andresc44/solidworks-cnc-mill-assembly/Solidworks/Needle-Roller_Bearing_assembly.SLDASM

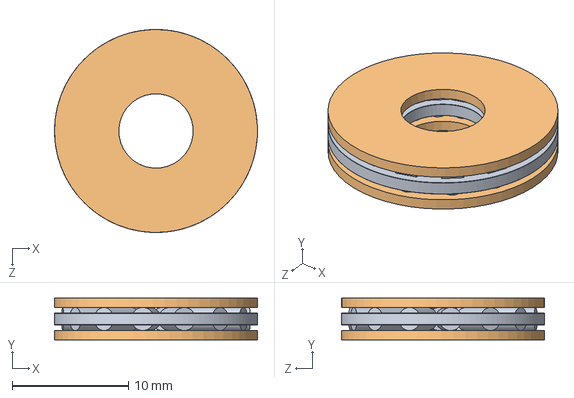
[picture p32: CAD file, 2025-07-18]
Solidworks/Needle-Roller_Bearing_assembly.SLDASM
17.5 x 3.61 x 17.5 mm
5909K230_THRUST NEEDLE-ROLLER BEARING
5909K231_THRUST NEEDLE-ROLLER BEARING x 2
