andresc44/solidworks-cnc-mill-assembly/Solidworks/C Plate assembly.SLDASM

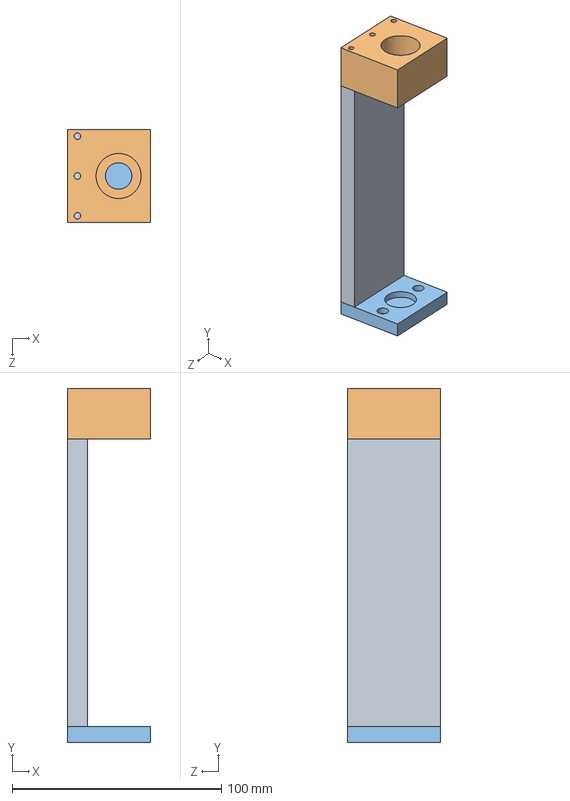
[picture p33: CAD file, 2025-07-18]
Solidworks/C Plate assembly.SLDASM
39.7 x 169.2 x 44.5 mm
Side of C plate
Top bar of C plate
bottom bar of C plate
