andresc44/solidworks-cnc-mill-assembly/Solidworks/CNC Assembly FINAL.SLDASM

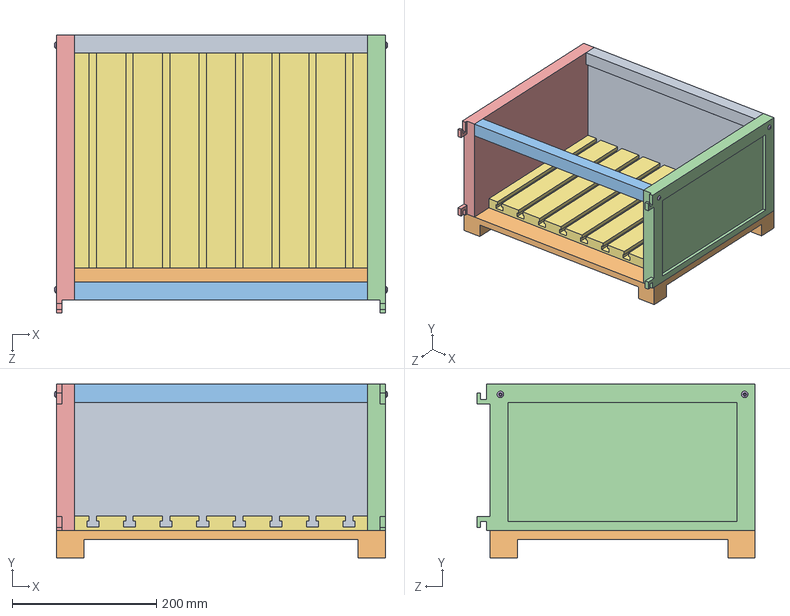
[picture p34: CAD file, 2025-07-18]
Solidworks/CNC Assembly FINAL.SLDASM
462.3 x 241.3 x 386.5 mm
frame backing
Frame bottom
frame front rod
frame sides
frame sides new
socket button head cap screw_ai x 8
12x12 t slot table
