andresc44/solidworks-cnc-mill-assembly/Solidworks/Clamp Assembly.SLDASM

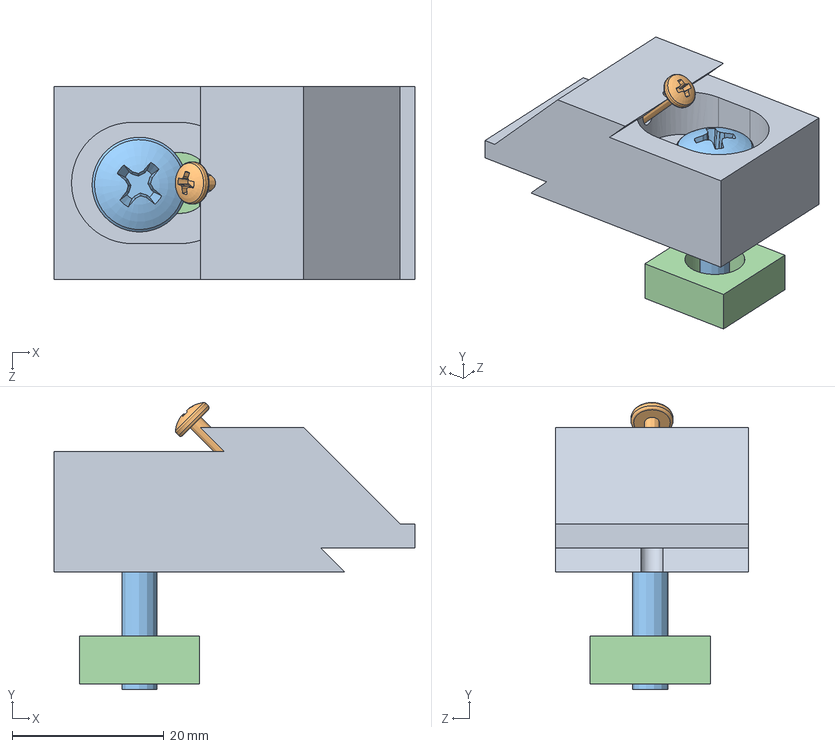
[picture p35: CAD file, 2025-07-18]
Solidworks/Clamp Assembly.SLDASM
47.6 x 37.9 x 25.4 mm
Toe clamp
91772A113_18-8 SS PAN HEAD PHILLIPS MACHINE SCREW
91735A542_TYPE 316 SS PAN HEAD PHILLIPS MACHINE SCREW
94855A278_LOW-STRENGTH STEEL SQUARE NUT
