andresc44/solidworks-cnc-mill-assembly/Solidworks/Top bar of C plate.SLDPRT

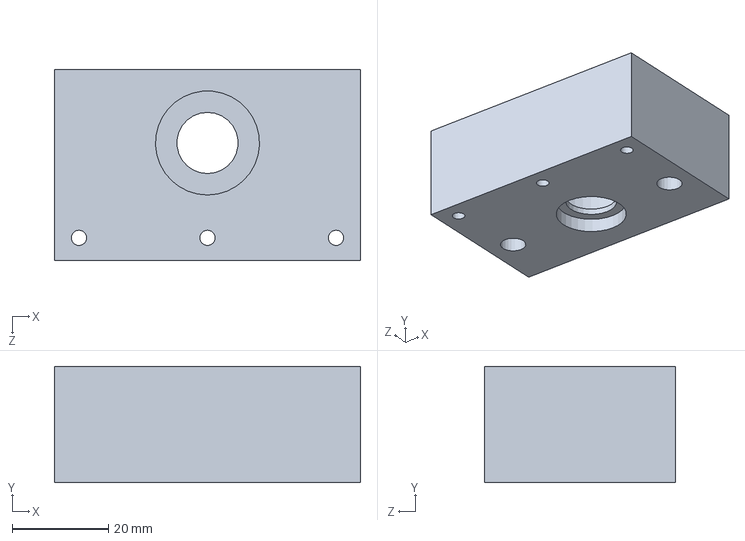
[picture p36: CAD file, 2025-07-18]
Solidworks/Top bar of C plate.SLDPRT
63.5 x 24.1 x 39.6 mm
