andresc44/solidworks-cnc-mill-assembly/Solidworks/Toe clamp.SLDPRT

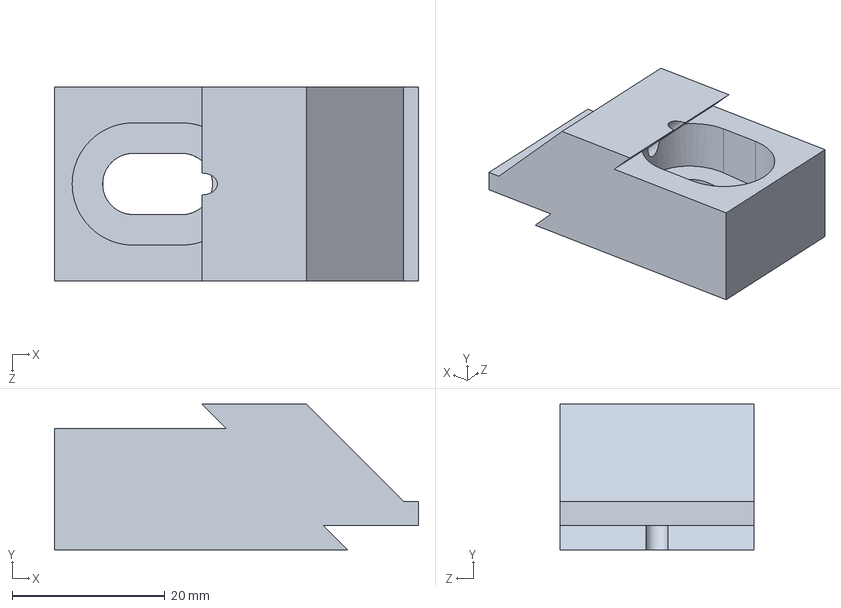
[picture p38: CAD file, 2025-07-18]
Solidworks/Toe clamp.SLDPRT
47.6 x 19.1 x 25.4 mm
