andresc44/solidworks-cnc-mill-assembly/Solidworks/Frame bottom.SLDPRT

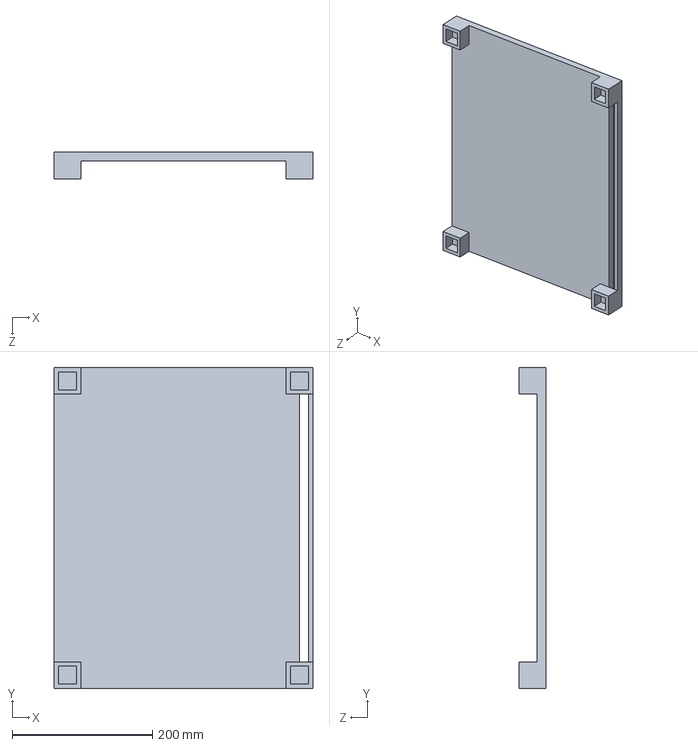
[picture p39: CAD file, 2025-07-18]
Solidworks/Frame bottom.SLDPRT
368.3 x 457.2 x 38.1 mm
