andresc44/solidworks-cnc-mill-assembly/Solidworks/motor_holder.SLDPRT

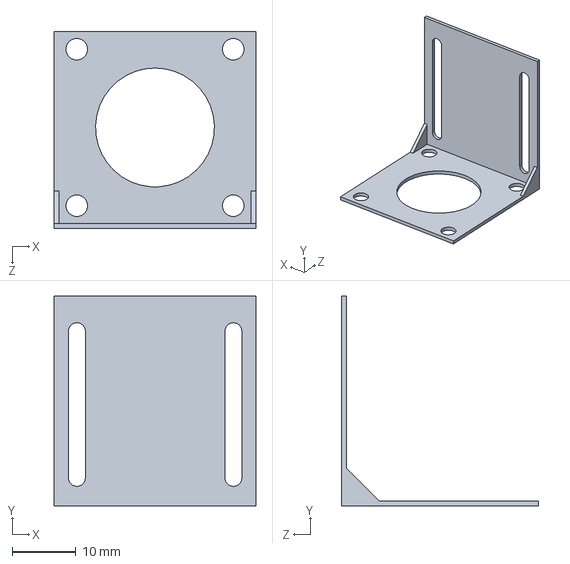
[picture p40: CAD file, 2025-07-18]
Solidworks/motor_holder.SLDPRT
31.8 x 33.0 x 31.0 mm
