andresc44/solidworks-cnc-mill-assembly/Solidworks/frame sides.SLDPRT

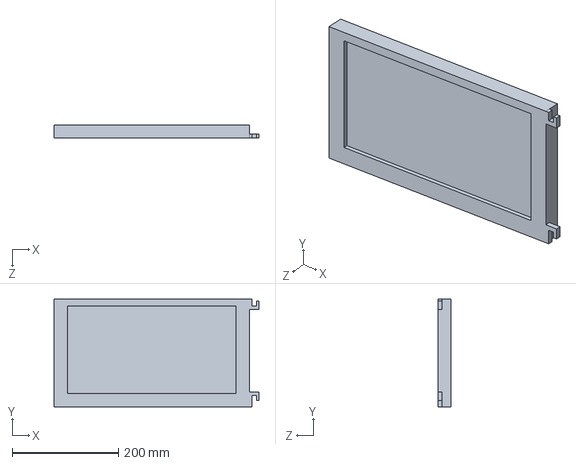
[picture p41: CAD file, 2025-07-18]
Solidworks/frame sides.SLDPRT
386.5 x 203.2 x 25.4 mm
