andresc44/solidworks-cnc-mill-assembly/Solidworks/frame front rod.SLDPRT

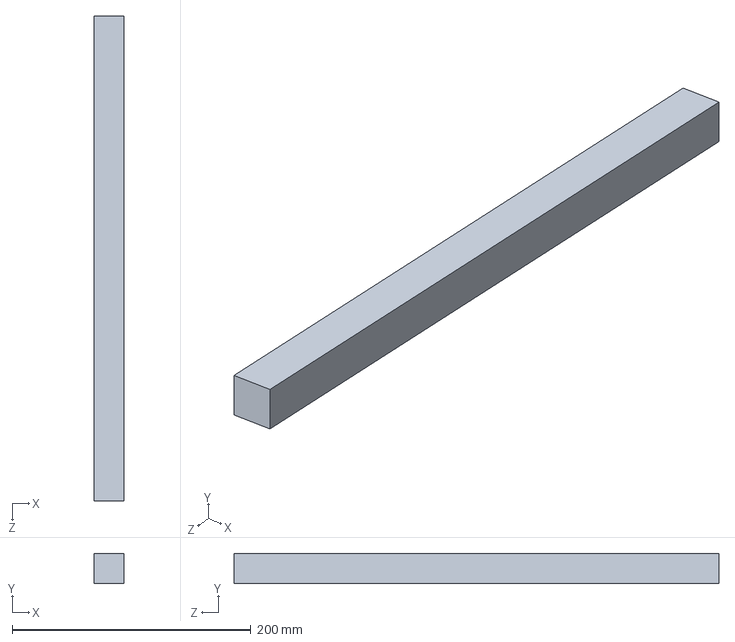
[picture p42: CAD file, 2025-07-18]
Solidworks/frame front rod.SLDPRT
25.4 x 25.4 x 406.4 mm
