andresc44/solidworks-cnc-mill-assembly/Solidworks/Side of C plate.SLDPRT

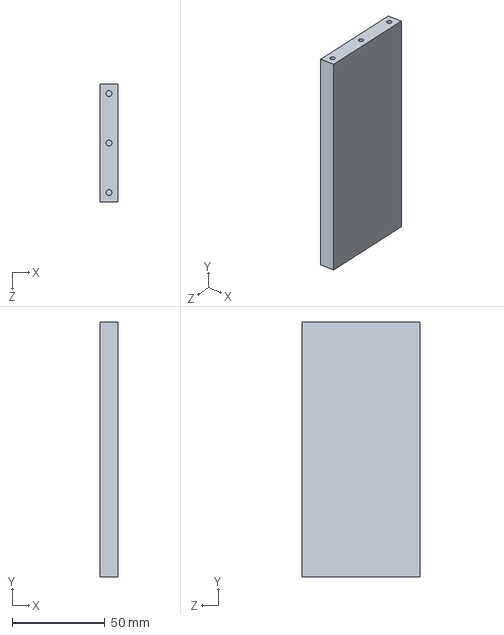
[picture p43: CAD file, 2025-07-18]
Solidworks/Side of C plate.SLDPRT
9.53 x 137.4 x 63.5 mm
