andresc44/solidworks-cnc-mill-assembly/Solidworks/traywey (1).SLDPRT

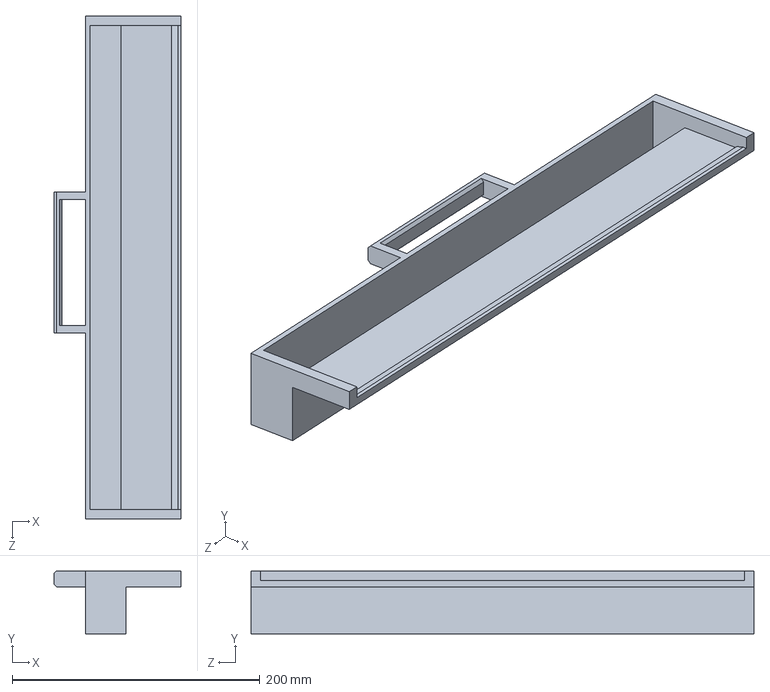
[picture p44: CAD file, 2025-07-18]
Solidworks/traywey (1).SLDPRT
102.5 x 50.8 x 406.4 mm
