andresc44/solidworks-cnc-mill-assembly/Solidworks/spindle plate vertical.SLDPRT

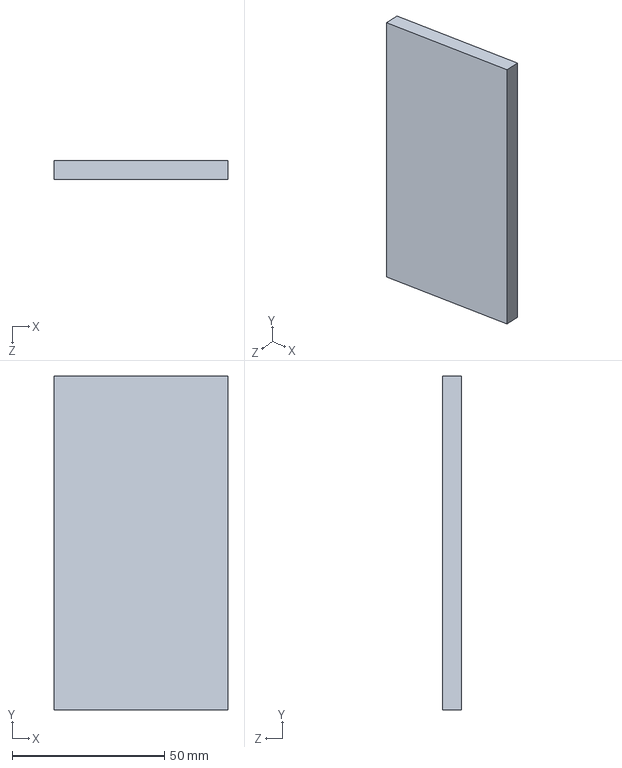
[picture p45: CAD file, 2025-07-18]
Solidworks/spindle plate vertical.SLDPRT
57.2 x 109.7 x 6.35 mm
