andresc44/solidworks-cnc-mill-assembly/Solidworks/Spindle holder top.SLDPRT

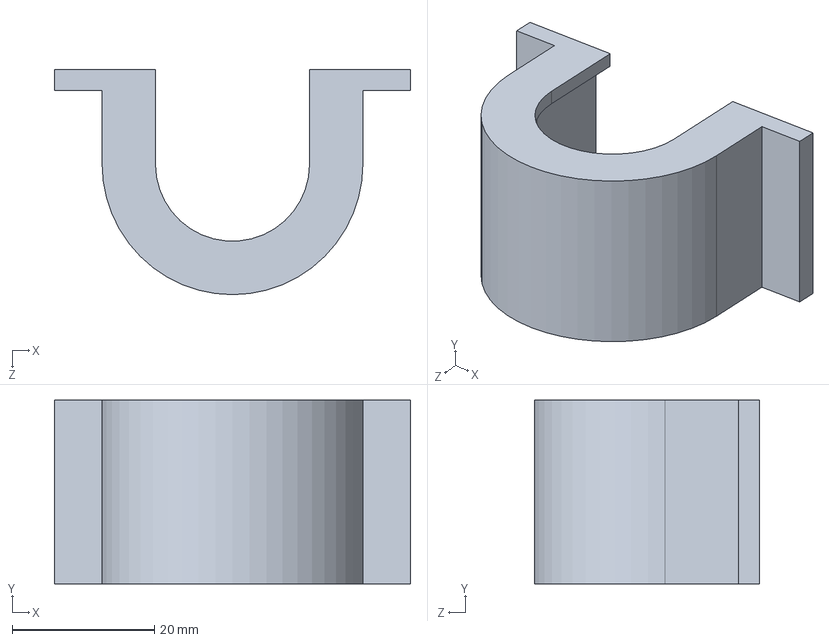
[picture p46: CAD file, 2025-07-18]
Solidworks/Spindle holder top.SLDPRT
50.0 x 25.8 x 31.6 mm
