andresc44/solidworks-cnc-mill-assembly/Solidworks/Housing for X motion Parts_NO_COUPLING.SLDPRT

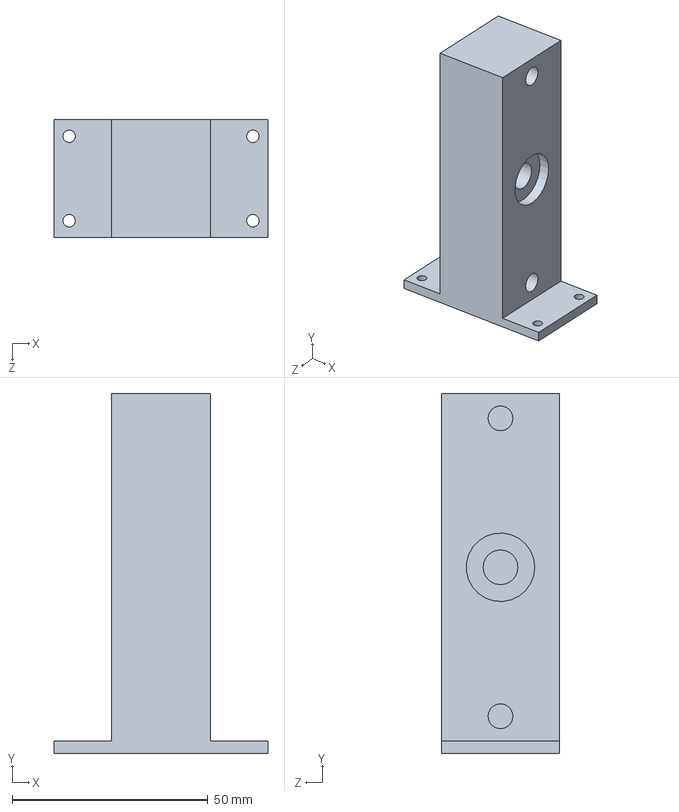
[picture p47: CAD file, 2025-07-18]
Solidworks/Housing for X motion Parts_NO_COUPLING.SLDPRT
54.6 x 92.1 x 30.2 mm
