andresc44/solidworks-cnc-mill-assembly/Solidworks/hose connector.SLDPRT

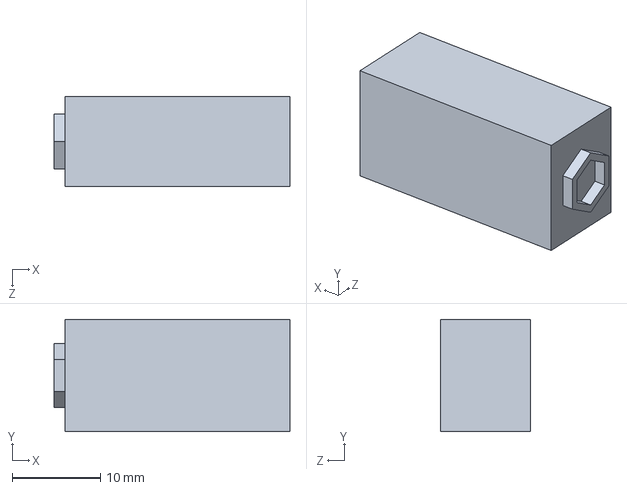
[picture p48: CAD file, 2025-07-18]
Solidworks/hose connector.SLDPRT
26.7 x 12.7 x 10.2 mm
