andresc44/solidworks-cnc-mill-assembly/Solidworks/frame backing.SLDPRT

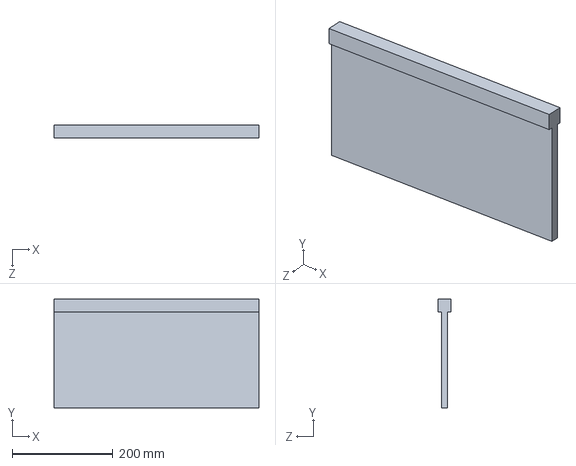
[picture p49: CAD file, 2025-07-18]
Solidworks/frame backing.SLDPRT
406.4 x 215.9 x 25.4 mm
