andresc44/solidworks-cnc-mill-assembly/Solidworks/hose.SLDPRT

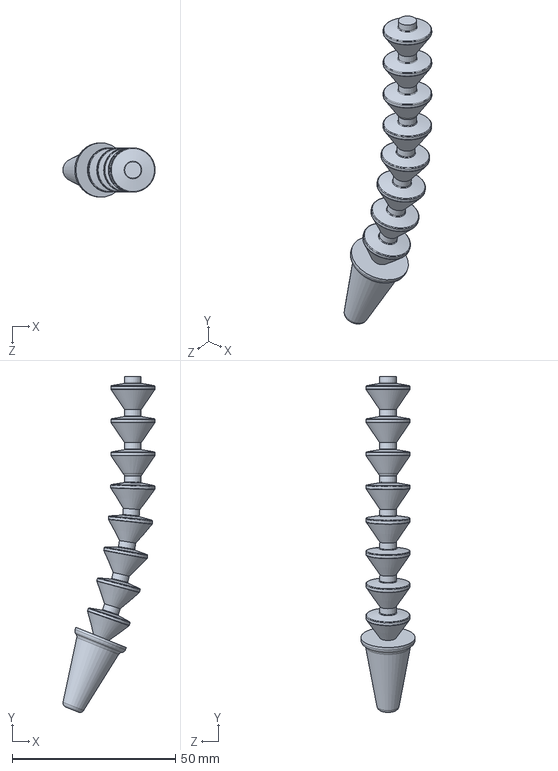
[picture p50: CAD file, 2025-07-18]
Solidworks/hose.SLDPRT
28.3 x 103.1 x 16.7 mm
