andresc44/solidworks-cnc-mill-assembly/Solidworks/Spindle holder.SLDPRT

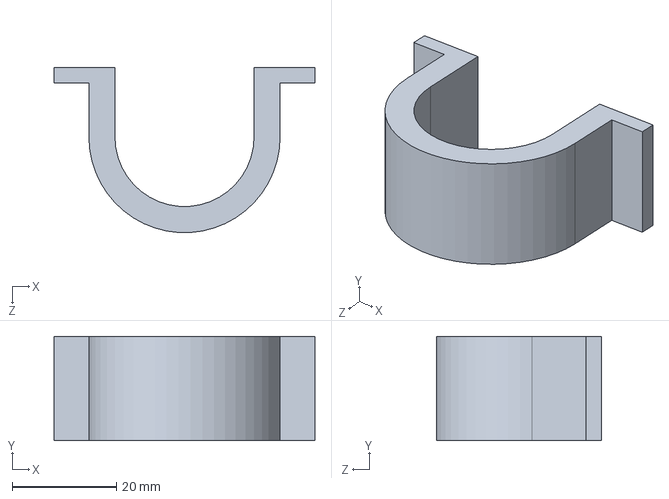
[picture p51: CAD file, 2025-07-18]
Solidworks/Spindle holder.SLDPRT
50.0 x 20.0 x 31.6 mm
