andresc44/solidworks-cnc-mill-assembly/Solidworks/motor clamp.SLDPRT

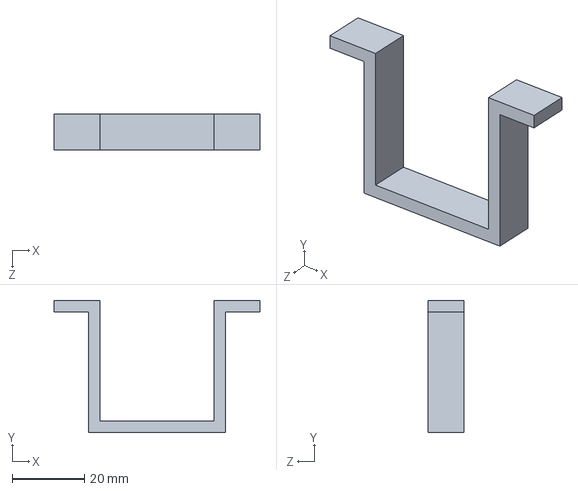
[picture p52: CAD file, 2025-07-18]
Solidworks/motor clamp.SLDPRT
57.0 x 36.6 x 10.0 mm
