andresc44/solidworks-cnc-mill-assembly/Solidworks/hose connector holder.SLDPRT

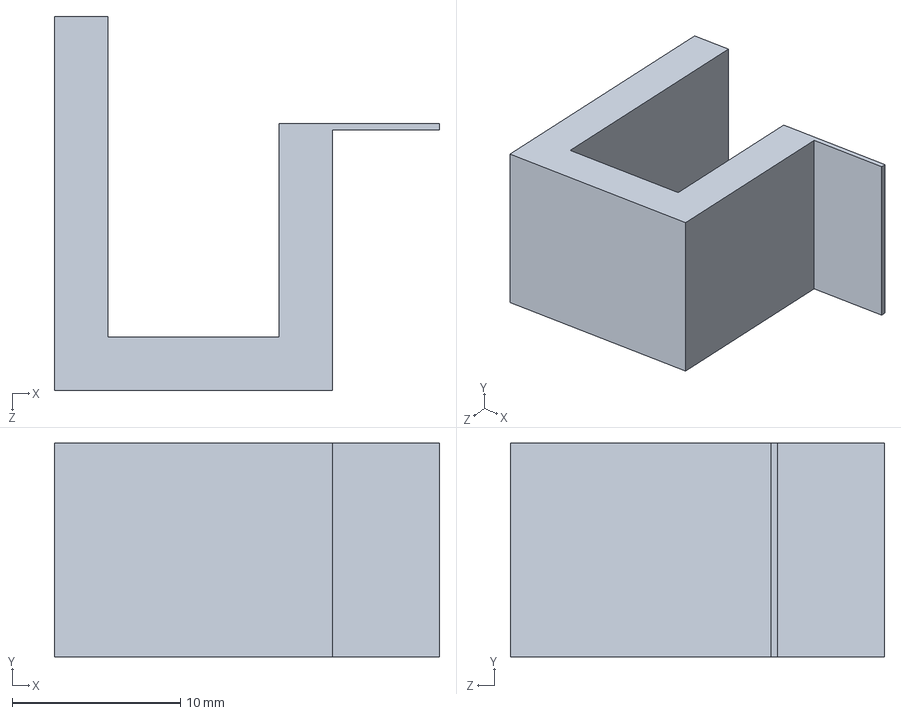
[picture p53: CAD file, 2025-07-18]
Solidworks/hose connector holder.SLDPRT
22.9 x 12.7 x 22.2 mm
