andresc44/solidworks-cnc-mill-assembly/Solidworks/Spindle.SLDPRT

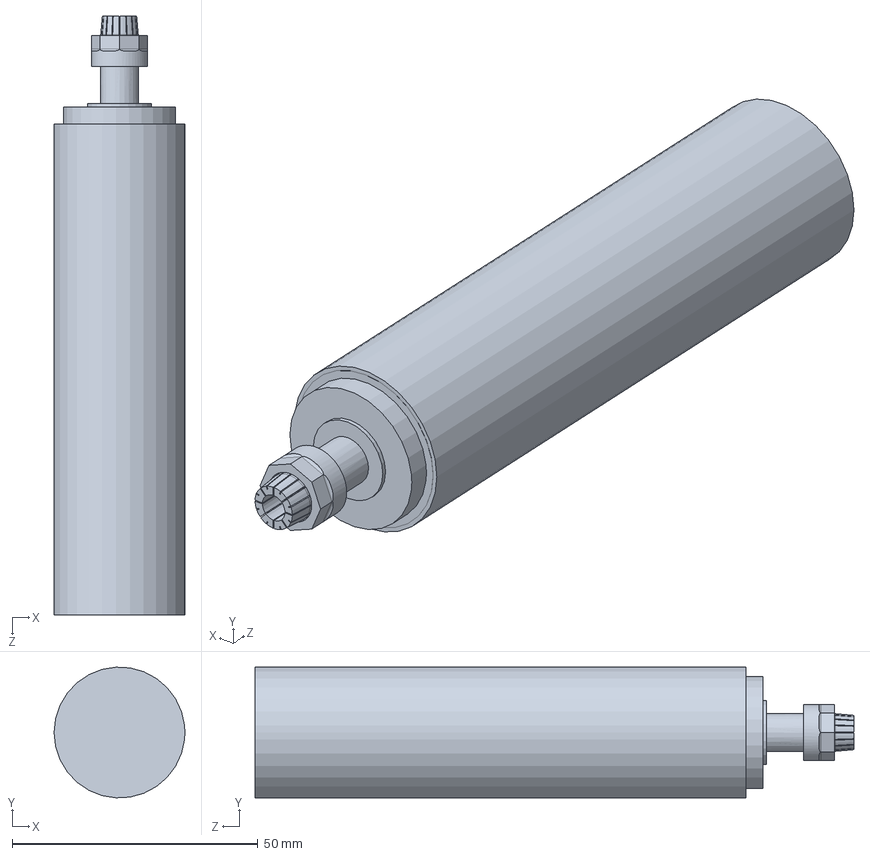
[picture p54: CAD file, 2025-07-18]
Solidworks/Spindle.SLDPRT
26.6 x 26.6 x 121.9 mm
