andresc44/solidworks-cnc-mill-assembly/Solidworks/new_new_bearing holder.SLDPRT

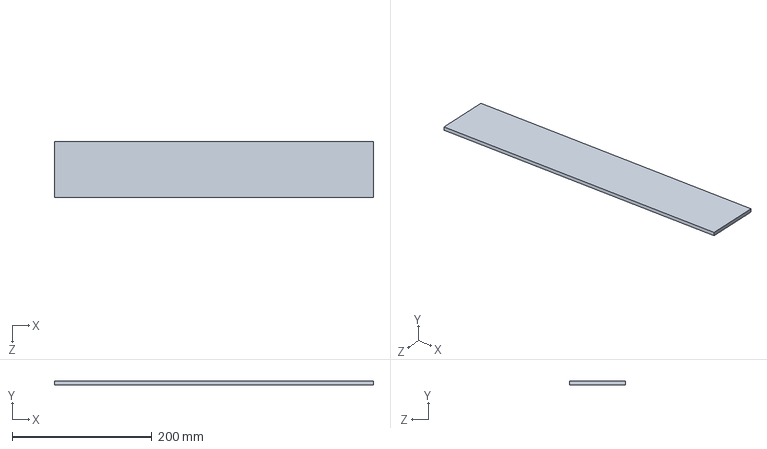
[picture p55: CAD file, 2025-07-18]
Solidworks/new_new_bearing holder.SLDPRT
457.2 x 5.08 x 80.0 mm
