andresc44/solidworks-cnc-mill-assembly/Solidworks/motor body.SLDPRT

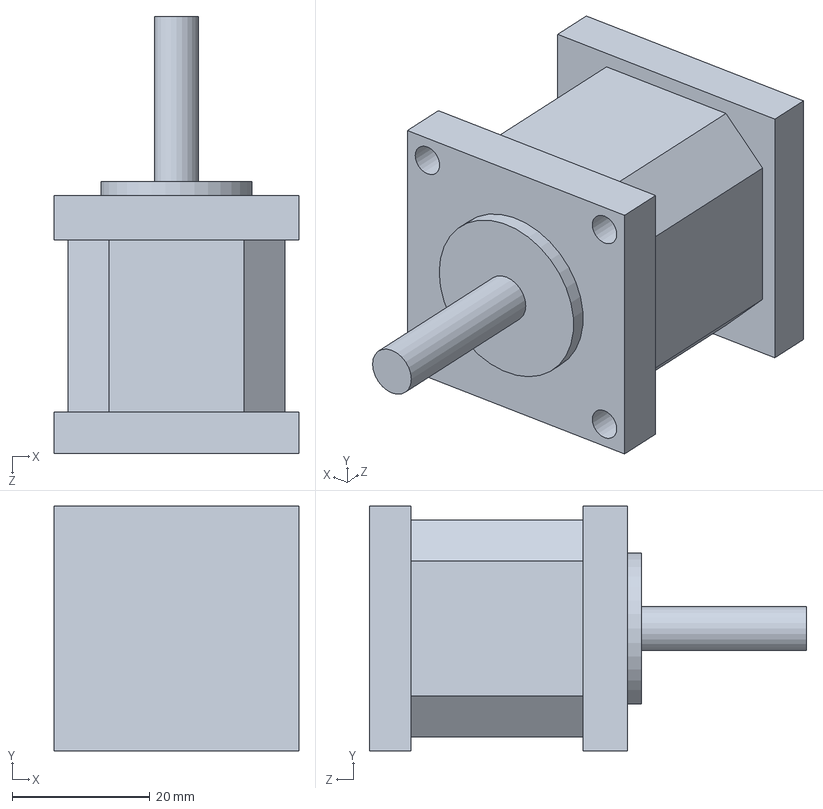
[picture p56: CAD file, 2025-07-18]
Solidworks/motor body.SLDPRT
35.6 x 35.6 x 63.5 mm
