andresc44/solidworks-cnc-mill-assembly/Solidworks/new_bearing holder.SLDPRT

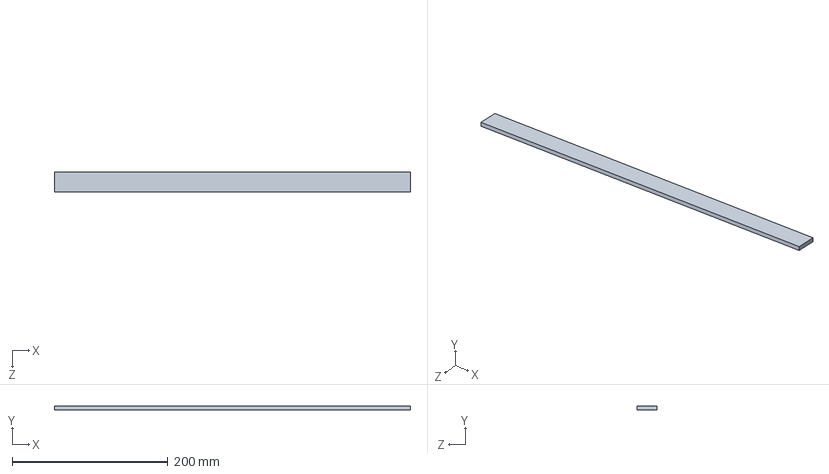
[picture p57: CAD file, 2025-07-18]
Solidworks/new_bearing holder.SLDPRT
457.2 x 5.08 x 25.4 mm
