andresc44/solidworks-cnc-mill-assembly/Solidworks/Connector plate.SLDPRT

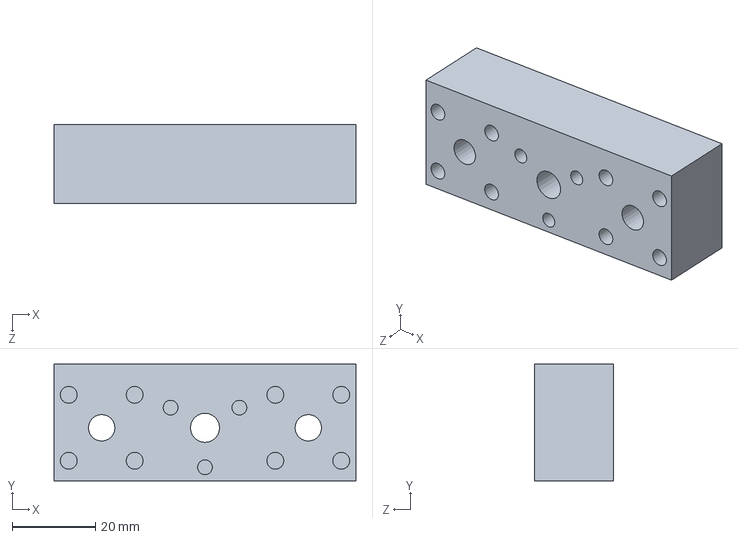
[picture p58: CAD file, 2025-07-18]
Solidworks/Connector plate.SLDPRT
72.4 x 27.9 x 19.0 mm
