andresc44/solidworks-cnc-mill-assembly/Solidworks/Bearing housing with coupling better.SLDPRT

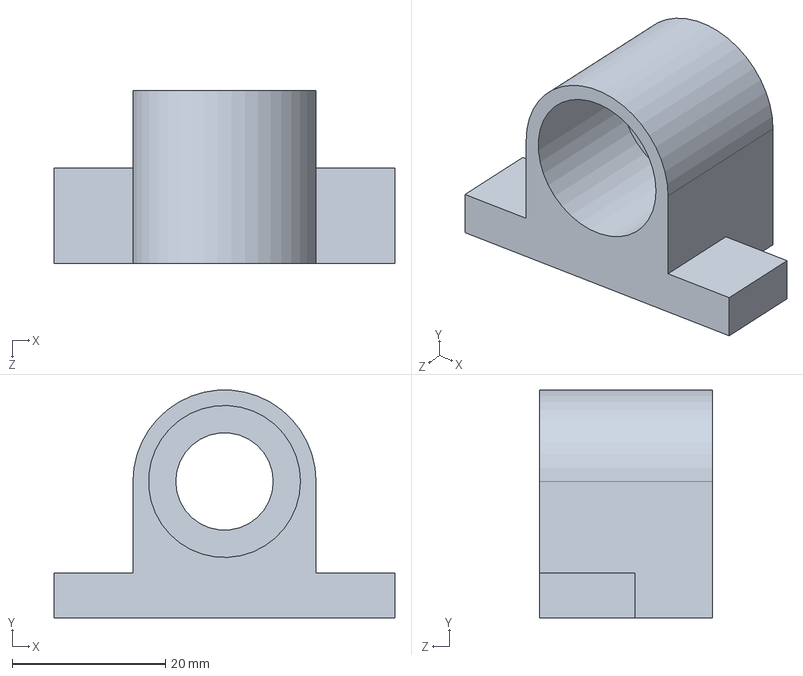
[picture p59: CAD file, 2025-07-18]
Solidworks/Bearing housing with coupling better.SLDPRT
44.5 x 29.7 x 22.6 mm
