andresc44/solidworks-cnc-mill-assembly/Solidworks/bottom bar of C plate.SLDPRT

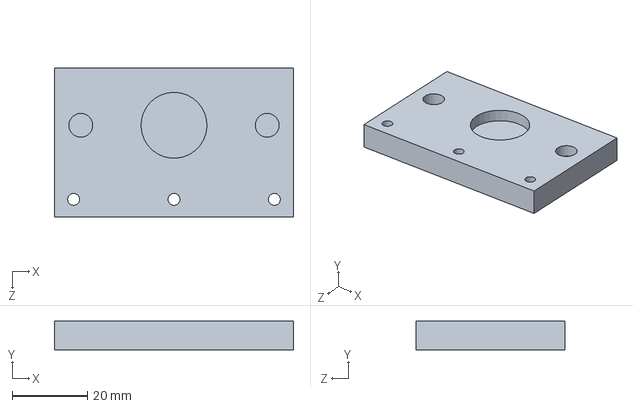
[picture p60: CAD file, 2025-07-18]
Solidworks/bottom bar of C plate.SLDPRT
63.5 x 7.62 x 39.6 mm
