andresc44/solidworks-cnc-mill-assembly/Solidworks/cnc pump.SLDPRT

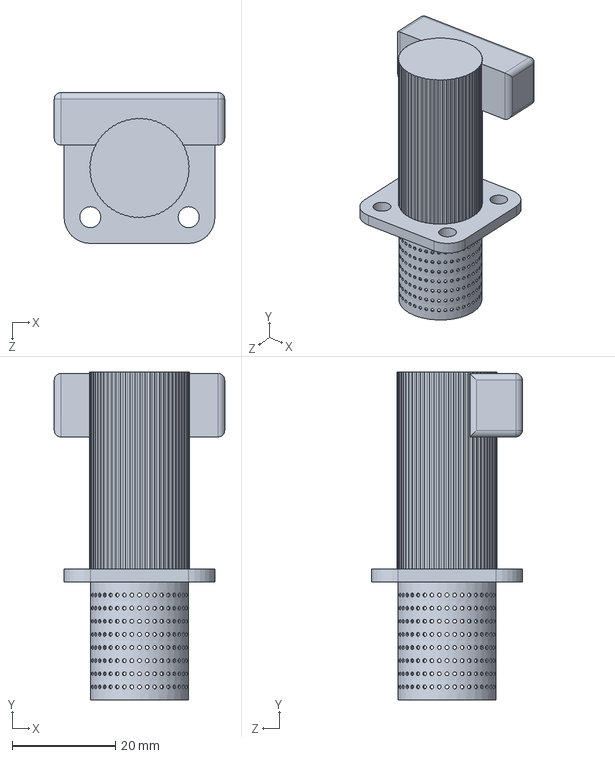
[picture p62: CAD file, 2025-07-18]
Solidworks/cnc pump.SLDPRT
33.0 x 63.5 x 29.2 mm
