andresc44/solidworks-cnc-mill-assembly/Solidworks/12 inch shaft.SLDPRT

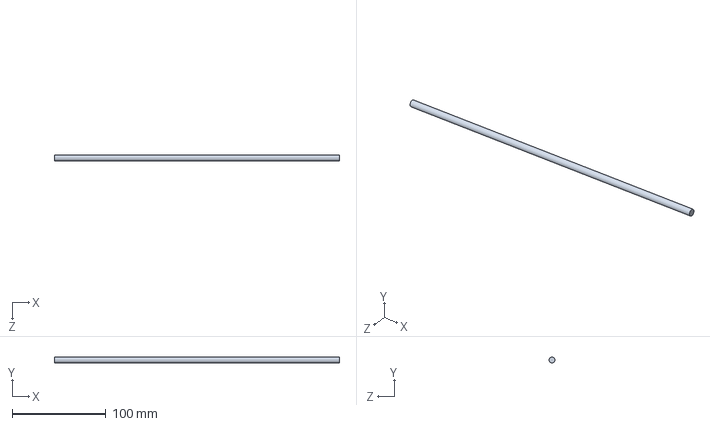
[picture p63: CAD file, 2025-07-18]
Solidworks/12 inch shaft.SLDPRT
304.8 x 6.35 x 6.35 mm
