andresc44/solidworks-cnc-mill-assembly/Solidworks/12x12 t slot table.SLDPRT

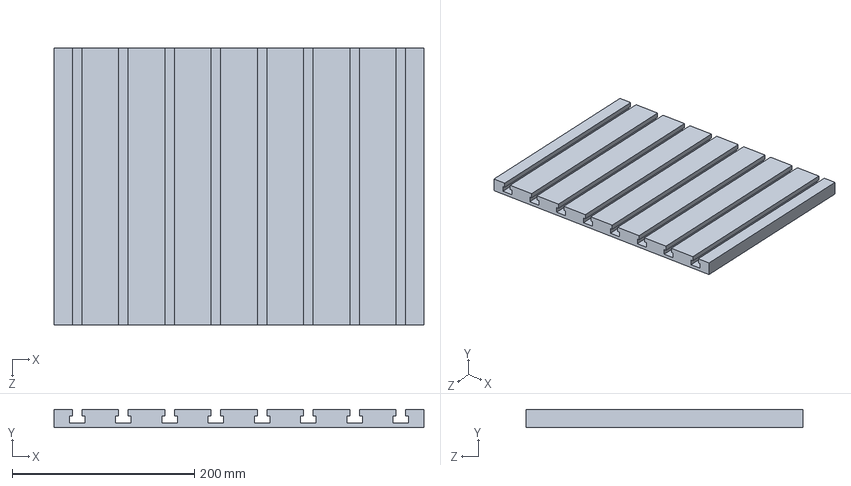
[picture p64: CAD file, 2025-07-18]
Solidworks/12x12 t slot table.SLDPRT
406.4 x 20.0 x 304.8 mm
