andresc44/solidworks-cnc-mill-assembly/Solidworks/6 inch shaft.SLDPRT

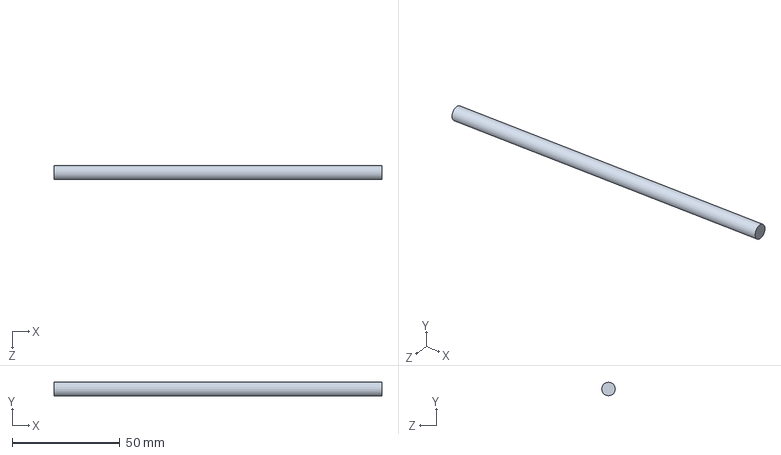
[picture p65: CAD file, 2025-07-18]
Solidworks/6 inch shaft.SLDPRT
152.4 x 6.35 x 6.35 mm
