andresc44/solidworks-cnc-mill-assembly/(list of files, cad)

Other CAD files:
Solidworks/frame sides new.SLDPRT
Solidworks/1865K100_EASY-ACCESS BASE-MOUNTED SHAFT SUPPORT.SLDPRT
Solidworks/5909K230_THRUST NEEDLE-ROLLER BEARING.SLDPRT
Solidworks/5909K231_THRUST NEEDLE-ROLLER BEARING.SLDPRT
Solidworks/6350K208_ULTRA-PRECISION LEAD SCREW (1).SLDPRT
Solidworks/6374K115_MOUNTED LINEAR SLEEVE BRNG.SLDPRT
Solidworks/6483K610_FLANGE-MOUNTED LINEAR BALL BRNG.SLDPRT
Solidworks/6698K510_PRECISION ACME RIGHT-HAND COLLAR.SLDPRT
Solidworks/91735A542_TYPE 316 SS PAN HEAD PHILLIPS MACHINE SCREW.SLDPRT
Solidworks/91772A030_18-8 SS PAN HEAD PHILLIPS MACHINE SCREW.SLDPRT
Solidworks/91772A112_18-8 SS PAN HEAD PHILLIPS MACHINE SCREW.SLDPRT
Solidworks/91772A113_18-8 SS PAN HEAD PHILLIPS MACHINE SCREW.SLDPRT
Solidworks/91772A116_18-8 SS PAN HEAD PHILLIPS MACHINE SCREW.SLDPRT
Solidworks/91772A194_18-8 SS PAN HEAD PHILLIPS MACHINE SCREW.SLDPRT
Solidworks/94855A278_LOW-STRENGTH STEEL SQUARE NUT.SLDPRT
Solidworks/9861T431_ALUMINUM HELICAL FLEXIBLE SHAFT COUPLING.SLDPRT
Solidworks/Assembly Drawing.SLDDRW
Solidworks/Bearing Housing.SLDDRW
Solidworks/Frame assembly 2.SLDDRW
Solidworks/Frame assembly 3.SLDDRW
Solidworks/Frame assembly.SLDDRW
Solidworks/Housing Attachment.SLDDRW
Solidworks/Lead Screw Attachment.SLDDRW
Solidworks/Lead Screw Holder.SLDPRT
Solidworks/Screw and nut.SLDASM
Solidworks/Treyway.SLDDRW
Solidworks/Y axis housing.SLDDRW
Solidworks/assembly drawing final.SLDDRW
Solidworks/c bar drawing 2.SLDDRW
Solidworks/c bar drawing.SLDDRW
Solidworks/lead screw plate.SLDPRT
Solidworks/lead screw plate_flip.SLDPRT
Solidworks/motor_body.SLDPRT
Solidworks/socket button head cap screw_ai.sldprt
