andresc44/solidworks-cnc-mill-assembly/(commit log)

2025-07-18 Added first set of solidworks files
    [12 inch shaft.SLDPRT, 12x12 t slot table.SLDPRT, 1865K100_EASY-ACCESS BASE-MOUNTED SHAFT SUPPORT.SLDPRT, 5909K230_THRUST NEEDLE-ROLLER BEARING.SLDPRT, 5909K231_THRUST NEEDLE-ROLLER BEARING.SLDPRT, 6 inch shaft.SLDPRT, 6350K208_ULTRA-PRECISION LEAD SCREW (1).SLDPRT]
2025-07-18 Added second set of solidworks files
    [6374K115_MOUNTED LINEAR SLEEVE BRNG.SLDPRT, 6483K610_FLANGE-MOUNTED LINEAR BALL BRNG.SLDPRT, 6698K510_PRECISION ACME RIGHT-HAND COLLAR.SLDPRT, 91735A542_TYPE 316 SS PAN HEAD PHILLIPS MACHINE SCREW.SLDPRT, 91772A030_18-8 SS PAN HEAD PHILLIPS MACHINE SCREW.SLDPRT, 91772A112_18-8 SS PAN HEAD PHILLIPS MACHINE SCREW.SLDPRT, 91772A113_18-8 SS PAN HEAD PHILLIPS MACHINE SCREW.SLDPRT, 91772A116_18-8 SS PA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]
2025-07-18 Upload third set of solidworks files
    [Frame assembly 2.SLDDRW, Frame assembly 3.SLDDRW, Frame assembly.SLDDRW, Frame bottom.SLDPRT, Housing Attachment.SLDDRW, Housing for X motion Parts.SLDPRT, Housing for X motion Parts_NO_COUPLING.SLDPRT, Lead Screw Attachment.SLDDRW]
2025-07-18 Upload assembly file
